jaz404/visarm/notes.md

# Kinematics of 5DOF Arm

## Introduction

Our arm has 6 revolute joints, with no prismatic joints (i.e., the robot can only rotate at places). The wrist rotates as well. It has 3 joints parallel to each other.

### Types of joints

Revolute vs Prismatic Joint

## D-H (Denavit Hartenburg Parameters)

This is a convention used to understand and define the parameters of a robot.

#### Link and Joint Paramters:

- Link Lenght (a<sub>i-1</sub>): It is the mutual perpendictular distance between 2 axis. This is the distance from z<sub>i</sub> to z<sub>i+1</sub>
- Link Twist (α<sub>i-1</sub>): Angle from axis i-1 to i. This is the angle from z<sub>i</sub> to z<sub>i+1</sub> measured about the x-axis.
- Link Offset (d<sub>i</sub>): The offset distance from one link to another. This is the distance from x<sub>i-1</sub> to x<sub>i</sub> along the z-axis
- Joint Angle (θ<sub>i</sub>): Rotation of link with respect to its neighbor (along the common axis). This is the angle from x<sub>i-1</sub> to x<sub>i</sub> measured about the z-axis.

<div align="center">
    Description
</div>

#### Example

<div align="center">
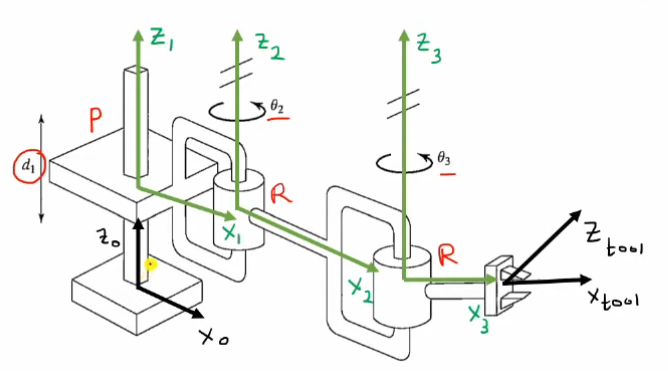
[picture p1: images/1.png]
    

<table>
    <tr>
        <th>Link (i)</th>
        <th>a<sub>i-1</sub></th>
        <th>α<sub>i-1</sub></th>
        <th>d<sub>i</sub></th>
        <th>θ<sub>i</sub></th>
    </tr>
    <tr>
        <td>1</td>
        <td>0</td>
        <td>0</td>
        <td>d<sub>1</sub></td>
        <td>0</td>
    </tr>
    <tr>
        <td>2</td>
        <td>L<sub>1</sub></td>
        <td>0</td>
        <td>0</td>
        <td>θ<sub>2</sub></td>
    </tr>
    <tr>
        <td>3</td>
        <td>L<sub>2</sub></td>
        <td>0</td>
        <td>0</td>
        <td>θ<sub>3</sub></td>
    </tr>
</table>
</div>

## Overview of the arm

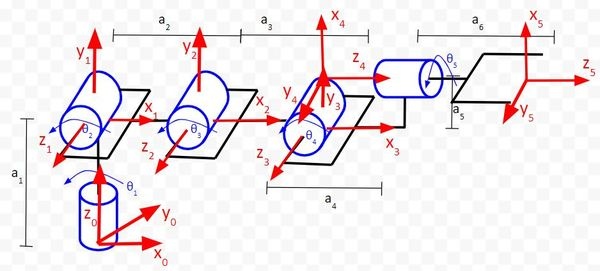
[picture p2: images/diagram.jpeg]


Note:

- θ is the angle from xn-1 to xn around zn-1.
- α is the angle from zn-1 to zn around xn.
- a is the distance between the origin of the n-1 frame and the origin of the n frame along the xn direction.
- d is the distance from xn-1 to xn along the zn-1 direction.

The arm has to following D-H parameters:

| Link (i) | θ<sub>i</sub> (°) | α<sub>i-1 (°) | d<sub>i</sub> (in cm) | a<sub>i-1</sub> (in cm) |
| --- | --- | --- | --- | --- |
| 1 | θ<sub>1</sub> | 90 | a<sub>1</sub> | 0 |
| 2 | θ<sub>2</sub> + pi/2  | 0 | 0 | a<sub>2</sub> |
| 3 | -θ<sub>3</sub> | 0 | 0 | a<sub>3</sub> |
| 4 | -θ<sub>4</sub> + pi/2 | 90 | 0 | a<sub>5</sub> |
| 5 | θ<sub>5</sub> | 0 | a<sub>4</sub> + a<sub>6</sub> | 0 |

(For joints 2, 3, and 4 if you want to change the direction in the global x axis, negate theta.)

Substituting values we get:

| Link (i) | θ<sub>i</sub> (°) | α<sub>i-1 (°) | d<sub>i</sub> (in cm) | a<sub>i-1</sub> (in cm) |
| --- | --- | --- | --- | --- |
| 1 | θ<sub>1</sub> | 90 | 2 | 0 |
| 2 | θ<sub>2</sub> + pi/2  | 0 | 0 | 10.3 |
| 3 | -θ<sub>3</sub> | 0 | 0 | 9.6 |
| 4 | -θ<sub>4</sub> + pi/2 | 90 | 0 | 2.5 |
| 5 | θ<sub>5</sub> | 0 | 9 | 0 |

## Forward kinematics:

This is easy to calculate. Give the angles, the translations and the link lenghts and it will output the position of the end-effector. It works by applying transformation matrices at each joint and hence we get the end-effector position in the final.

## Inverse Kinematics:

### When does inverse kinematics have a closed form solution

The inverse kinematics has a closed form solution in the following two conditions:

- 3 of its joints are parallel to each other
- 3 of its joints has a rotation axis that intersect at a common point.

### Overview

Given the position and orientaion to point to, find the joint angles so that the end-effector moves and orients to the desired point.

### Calculation

Since the robot has 5 revolute joints, we need to find 5 angles to move the robot. This involves transformations from the end-effector to the base of the robot.

#### Velocities

The Jacobian is used to transform the joint velocities into end-effector velocities as follows:

$$
\begin{bmatrix}
ẋ \cr
ẏ \cr
ż \cr
ω_x\cr
ω_y\cr
ω_z\cr
\end{bmatrix}_{6x1} =
J_{6xn}\begin{bmatrix}
q̇_1  \cr
q̇_2 \cr
q̇_3 \cr
... \cr
q̇_n\cr
\end{bmatrix}_{nx1}
$$

Therefore, in our case it would be:

$$
\begin{bmatrix}
ẋ \cr
ẏ \cr
ż \cr
ω_x\cr
ω_y\cr
ω_z\cr
\end{bmatrix}_{6x1} =
J_{6x5}\begin{bmatrix}
θ_1  \cr
θ_2 \cr
θ_3 \cr
θ_4 \cr
θ_5\cr
\end{bmatrix}_{5x1}
$$

#### Jacobian

The jacobian would be a mxn matrix where m represents the dimensions (2D or 3D) and n represents the number of joints. In our case it would be 6x5 matrix as we are in 3D (so 3 for position and 3 for orientation) and 5 joints that determine the arms position / orientation.

The jacobian can be divided into two parts, the first three for linear velocities and the bottom three for angular velocities:

$$
\begin{bmatrix}
J_v  \cr
J_ω \cr
\end{bmatrix}_{6x5}
$$

#### Analytical Method

##### Option 1: Failed
We will try to extract a mathematical formula for the arm so that it is easy to compute. Our robot satifies the Pieper's law as the 2nd, 3rd and 4th joints are parallel and so we can find an analytical solution.

- Assumption 1: The wrist position (Joint 4) depends on the first three joints. (0 to 3)
- Assumption 2: The wrist orientation depends on the last two (that is joint 4 and joint 5). (The homogenous transformation from 5 to 3).

This failed because the arm's 4 joint is not spherical, so it keeps changing. This causes the d5 value in the equation (W = P - d5*Z5) to keep changing based on the orientation of theta 4. Tried to do a brute force approach but didn't give very good results.

##### Option 2: Brute force calulation using the transformation matrices:
A simplified version of this looks as follows:
[-cos(-θ₂ + θ₃ + θ₄))⋅cos(θ₁)⋅cos(θ₅) + sin(θ₁)⋅sin(θ₅), cos(-θ₂ + θ₃ + θ₄))⋅sin(θ₅)⋅cos(θ₁) + sin(θ₁)⋅cos(θ₅), sin(-θ₂ + θ₃ + θ₄)⋅cos(θ₁), (-10.3⋅sin(θ₂) - 9.6⋅sin(θ₂ - θ₃) + 9.0⋅sin(-θ₂ + θ₃ + θ₄) - 2.5⋅cos(-θ₂ + θ₃ + θ₄))⋅cos(θ₁)] = [R11, R12, R13, Px]
[-cos(-θ₂ + θ₃ + θ₄))⋅sin(θ₁)⋅cos(θ₅) - sin(θ₅)⋅cos(θ₁), cos(-θ₂ + θ₃ + θ₄))⋅sin(θ₁)⋅sin(θ₅) - cos(θ₁)⋅cos(θ₅), sin(-θ₂ + θ₃ + θ₄)⋅sin(θ₁), (-10.3⋅sin(θ₂) - 9.6⋅sin(θ₂ - θ₃) + 9.0⋅sin(-θ₂ + θ₃ + θ₄) - 2.5⋅cos(-θ₂ + θ₃ + θ₄))⋅sin(θ₁)] = [R21, R22, R23, Py]
[sin(-θ₂ + θ₃ + θ₄)⋅cos(θ₅), -sin(-θ₂ + θ₃ + θ₄)⋅sin(θ₅), cos(-θ₂ + θ₃ + θ₄), 10.3⋅cos(θ₂) + 9.6⋅cos(θ₂ - θ₃) + 9.0⋅cos(-θ₂ + θ₃ + θ₄) - 2.5⋅sin(-θ₂ + θ₃ + θ₄) + 11.5] = [R31, R32, R33, Pz]
[0, 0, 0, 1] = [0, 0, 0, 1]

Goal: To solve for the joint angles θ₁, θ₂, θ₃, θ₄, and θ₅ given a desired end-effector pose defined by the rotation matrix [R] and position vector [P].
Equations:
1. -cos(-θ₂ + θ₃ + θ₄))⋅cos(θ₁)⋅cos(θ₅) = R11
2. -cos(-θ₂ + θ₃ + θ₄))⋅sin(θ₁)⋅cos(θ₅) = R21
3. sin(-θ₂ + θ₃ + θ₄)⋅cos(θ₅) = R31
4. cos(-θ₂ + θ₃ + θ₄))⋅sin(θ₁)⋅sin(θ₅) = R22
5. -sin(θ₅)⋅cos(θ₁) = R12
6. -sin(-θ₂ + θ₃ + θ₄)⋅sin(θ₅) = R32
7. sin(-θ₂ + θ₃ + θ₄)⋅cos(θ₁) = R13
8. sin(-θ₂ + θ₃ + θ₄)⋅sin(θ₁) = R23
9. cos(-θ₂ + θ₃ + θ₄) = R33
10. (-10.3⋅sin(θ₂) - 9.6⋅sin(θ₂ - θ₃) + 9.0⋅sin(-θ₂ + θ₃ + θ₄) - 2.5⋅cos(-θ₂ + θ₃ + θ₄))⋅cos(θ₁) = Px
11. (-10.3⋅sin(θ₂) - 9.6⋅sin(θ₂ - θ₃) + 9.0⋅sin(-θ₂ + θ₃ + θ₄) - 2.5⋅cos(-θ₂ + θ₃ + θ₄))⋅sin(θ₁) = Py
12. 10.3⋅cos(θ₂) + 9.6⋅cos(θ₂ - θ₃) + 9.0⋅cos(-θ₂ + θ₃ + θ₄) - 2.5⋅sin(-θ₂ + θ₃ + θ₄) + 11.5 = Pz

Solutions:
ϕ=-θ2+θ3+θ4
Then the equations become:
1. -cos(ϕ)⋅cos(θ₁)⋅cos(θ₅) = R11
2. -cos(ϕ)⋅sin(θ₁)⋅cos(θ₅) = R21
3. sin(ϕ)⋅cos(θ₅) = R31
4. cos(ϕ)⋅sin(θ₁)⋅sin(θ₅) = R22
5. -sin(θ₅)⋅cos(θ₁) = R12
6. -sin(ϕ)⋅sin(θ₅) = R32
7. sin(ϕ)⋅cos(θ₁) = R13
8. sin(ϕ)⋅sin(θ₁) = R23
9. cos(ϕ) = R33
10. A⋅cos(θ₁) = Px
11. A⋅sin(θ₁) = Py
12. B = Pz

Where:
A = -10.3⋅sin(θ₂) - 9.6⋅sin(θ₂ - θ₃) + 9.0⋅sin(ϕ) - 2.5⋅cos(ϕ)
B = 10.3⋅cos(θ₂) + 9.6⋅cos(θ₂ - θ₃) + 9.0⋅cos(ϕ) - 2.5⋅sin(ϕ) + 11.5

θ₁ = atan2(Py, Px)
θ₅ = atan2(-R12/cos(θ₁), -R11/(cos(ϕ)⋅cos(θ₁)))
ϕ = atan2(R31, R33) or ϕ = acos(R33)
θ4 = ϕ + θ2 - θ3
Solve for θ2 and θ3 using equations 10, 11, and 12.

This starts with an approximation, so it is not the best as there are some errors induced.

## Documentation

https://learn.adafruit.com/16-channel-pwm-servo-driver?view=all  
Servo driver library:  
https://github.com/NachtRaveVL/PCA9685-Arduino  
>Note: The servo.read() function does not provide feedback on the actual, current physical position of the servo motor shaft. Standard hobby servos are "open-loop" systems from the Arduino's perspective; the Arduino only sends a command signal and does not receive the actual position back from the servo's internal potentiometer.

## Joint Bounds

| Motor | Joint Name | Motion 1 (°) | Motion 2 (°) |
| ----- | --- | --- | --- |
| 1 | Base (ch 0) | +90 | -80 |
| 2 | Shoulder (ch 1) | +30 | -80 |
| 3 | Elbow (ch 2) | +90 | -90 |
| 4 | Wrist Roll (ch 3) | +90 | -90 |
| 5 | Wrist Yaw (ch 4)  | +90 | -90 |
| 6 | Gripper (ch 5) | +65 (open) | +90 (close)  |

## References

- https://www.youtube.com/watch?v=wDus2EKLg3s
- https://automaticaddison.com/the-ultimate-guide-to-jacobian-matrices-for-robotics/
- https://automaticaddison.com/homogeneous-transformation-matrices-using-denavit-hartenberg/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
- https://automaticaddison.com/the-ultimate-guide-to-inverse-kinematics-for-6dof-robot-arms/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

## Things to look into

- https://moveit.github.io/moveit_tutorials/doc/hand_eye_calibration/hand_eye_calibration_tutorial.html
- https://openrave.org/docs/0.8.0/openravepy/ikfast/

Home Position: -2, 0, 53, 90, 0, 0
