jaz404/visarm/assets/VISARM.pdf

CMPUT 312 FINAL PROJECT | 1

# Visarm: Vision based Pick-and-Place Robotic Arm

Jaspreet Singh Chhabra and Krupal Shah

Abstract—This project was aimed to create a 4DOF vision based pick-and-place system to color sort objects, enabling autonomous object localization, grasping, and placement. The process starts with correcting lens distortion to obtain a geometrically accurate view of the scene. A checkerboard workspace is then detected and used as a reference plane for mapping imagespace object locations into robot coordinates. Once objects within the workspace are detected, their positions are transformed into the robot frame solved using inverse kinematics. Inverse kinematics generates multiple solutions, which are evaluated through forward kinematics to identify a reachable solution. The robot executes the selected trajectory to grasp the object, followed by a verification step that confirms whether the pickup was successful. Successful grasps are subsequently placed into predefined bin locations. The system combines calibrated geometric vision with closed-loop grasp verification to ensure robust and consistent manipulation in a structured environment.

Index Terms—Robotic arms, Object Detection, Camera Calibration

I. INTRODUCTION
P
ICK-AND-PLACE systems using computer vision on robotic manipulators represent a core capability in modern automation, enabling robots to recognize, localize, and manipulate objects with minimal human intervention. In our final project, we investigate a vision-guided pick-and-place task to color sort objects using a 4-degree-of-freedom (4DOF) robotic arm. Such systems are widely used in real-world applications such as automated sorting in manufacturing lines, warehouse item classification, recycling facilities where materials are separated by type or color, and food processing environments that depend on visual inspection and sorting.

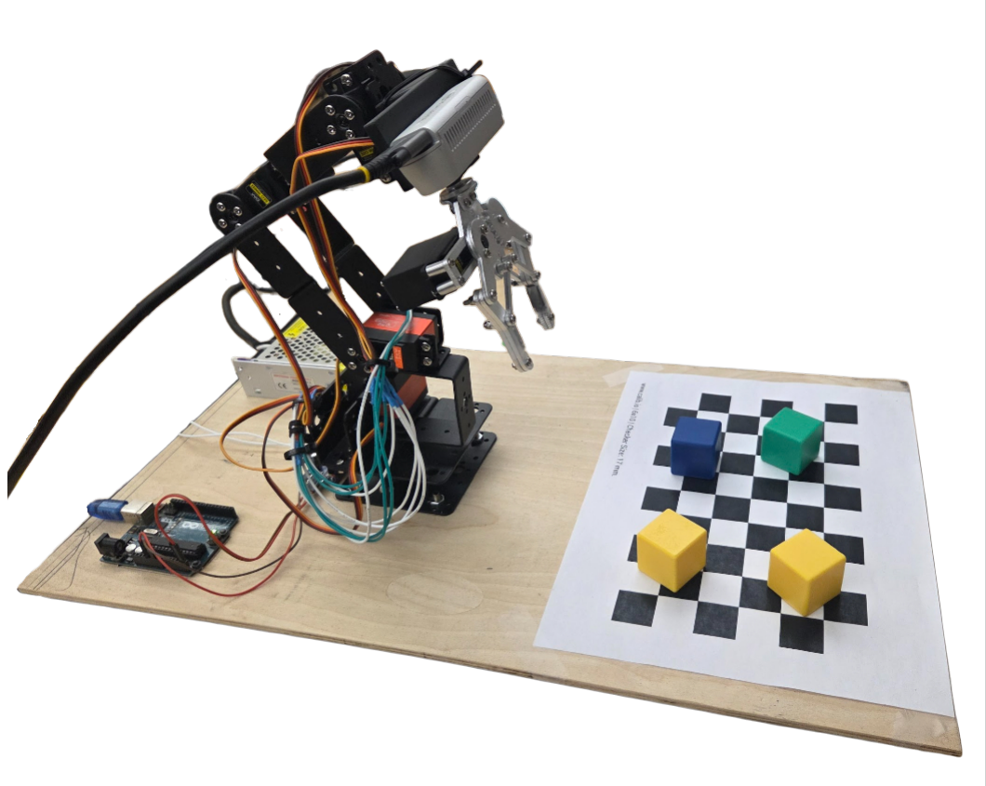
[picture p3: figure]

Fig. 1: Visarm Robotic Arm for Pick and Place

The use of a 4DOF robotic arm is particularly interesting because it offers a balance between mechanical simplicity and functional capability. With four independent joints, the robot can achieve a wide range of poses suitable for planar manipulation tasks while still presenting manageable kinematic complexity for analysis and control. The motivation for this project is to extend the knowledge gained from the CMPUT 312 course material and lab exercises to a more complex and sophisticated real-world robotic platform. Implementing vision-based control on a physical 4DOF robot provides practical experience with sensor integration, calibration challenges, and real-time motion execution, thereby deepening our understanding of robotic concepts and preparing for more advanced research or industrial applications.

II. RELATED WORKS

Previous research has demonstrated that even relatively simple manipulators, such as 3-DOF or 4-DOF robotic arms, can be effectively combined with computer vision systems to perform sorting and pick-and-place tasks. For instance, a 4-DOF robotic arm employing color-based image processing was used to sort colored balls in [1], while Gashi et al. [2] utilized a 3-DOF arm for object sorting. Despite the rise of deep learning approaches, many object detection and grasping tasks continue to rely on classical image processing techniques due to their lower computational cost, faster execution, greater predictability, and reduced data requirements [3]. These methods also offer easier calibration and deterministic behavior, particularly when the objects are simple, the background is controlled, and task speed is not critical.

Common techniques include color-based segmentation in HSV or other color spaces combined with contour detection and masking [4], edge detection methods such as the Hough transform, and hybrid pipelines that integrate 2D camera data with depth information to improve object localization [3]. These techniques have been studied extensively and applied in the CMPUT 312 course which have been extended in this project.

III. METHODOLOGY

A. Hardware

The core of the system is a low-cost robotic arm purchased from Amazon for approximately $80. Although advertised as a 6-DOF platform, the arm provides 5 functional degrees of freedom and is constructed primarily from sheet metal. The stock MG966R/MG996R servos offer approximately 13 kg·cm of torque and are driven by standard PWM signals without any onboard feedback mechanisms.

An Intel RealSense D435i camera was mounted on Joint 4 using a custom 3D-printed bracket to provide full visibility of the workspace. Due to the added weight of the camera, the base and shoulder servos were unable to provide sufficient torque for stable manipulation. These servos were replaced with higher torque Miuzei units rated at 22.8 kg·cm.

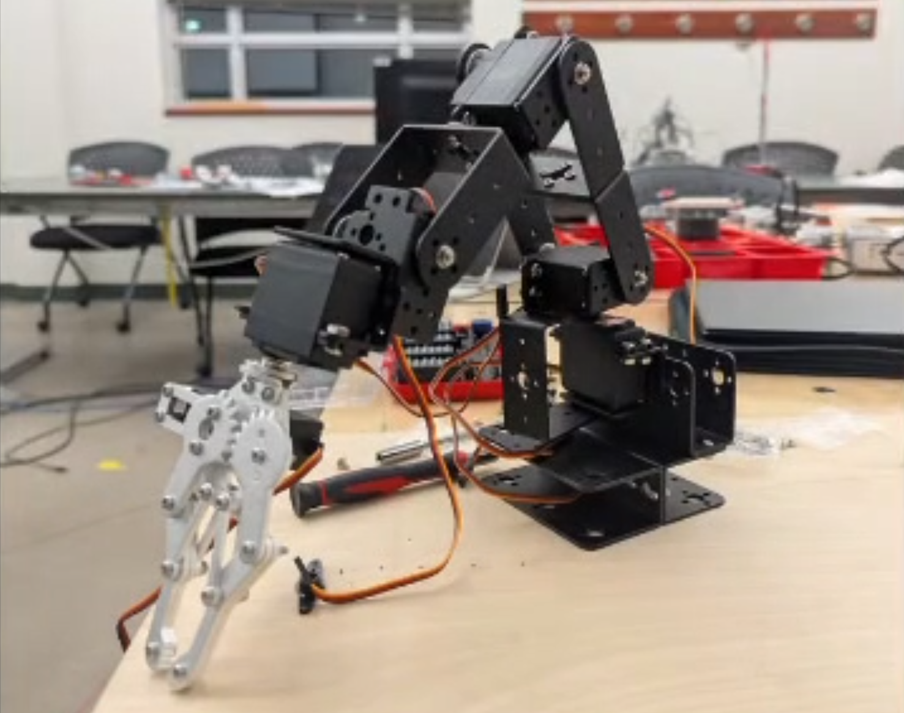
[picture p4: figure]

Fig. 2: Assembled Arm

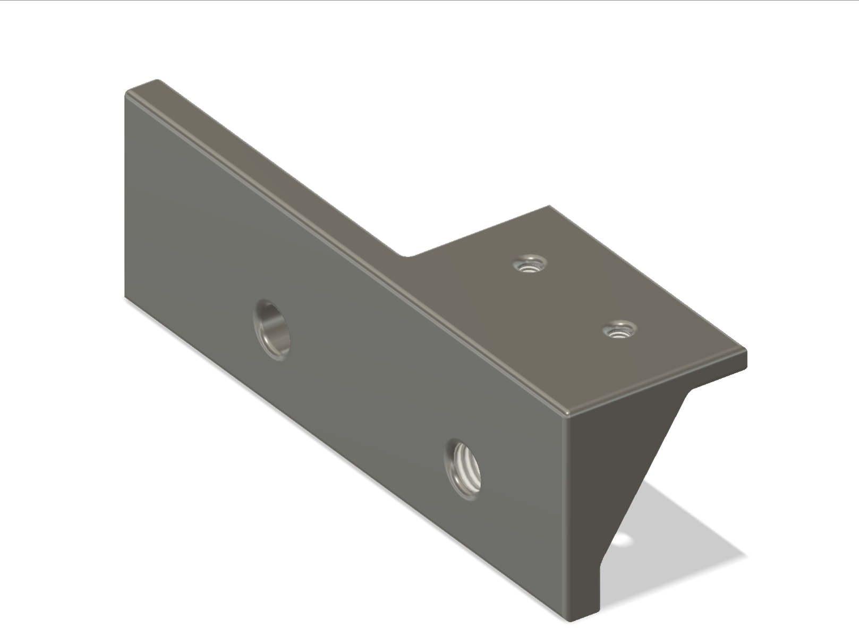
[picture p5: figure]

Fig. 3: 3D Printed Camera Mount for Intel RealSense

For controlling the motors, an Arduino UNO together with a PCA9685 16-channel PWM servo driver was used. The UNO receives serial commands from the host computer and generates the corresponding PWM signals for the servos. Because six servos draw a considerable amount of current under load, a 5 V switching-mode power supply capable of providing 10 A was sourced. All components were mounted on a 1/4” plywood board. The overall wiring layout, including the servo driver and power distribution, is illustrated in Figure 4. The workspace was defined using a 6×10 checkerboard with 23 mm tiles, which was also affixed to the board.

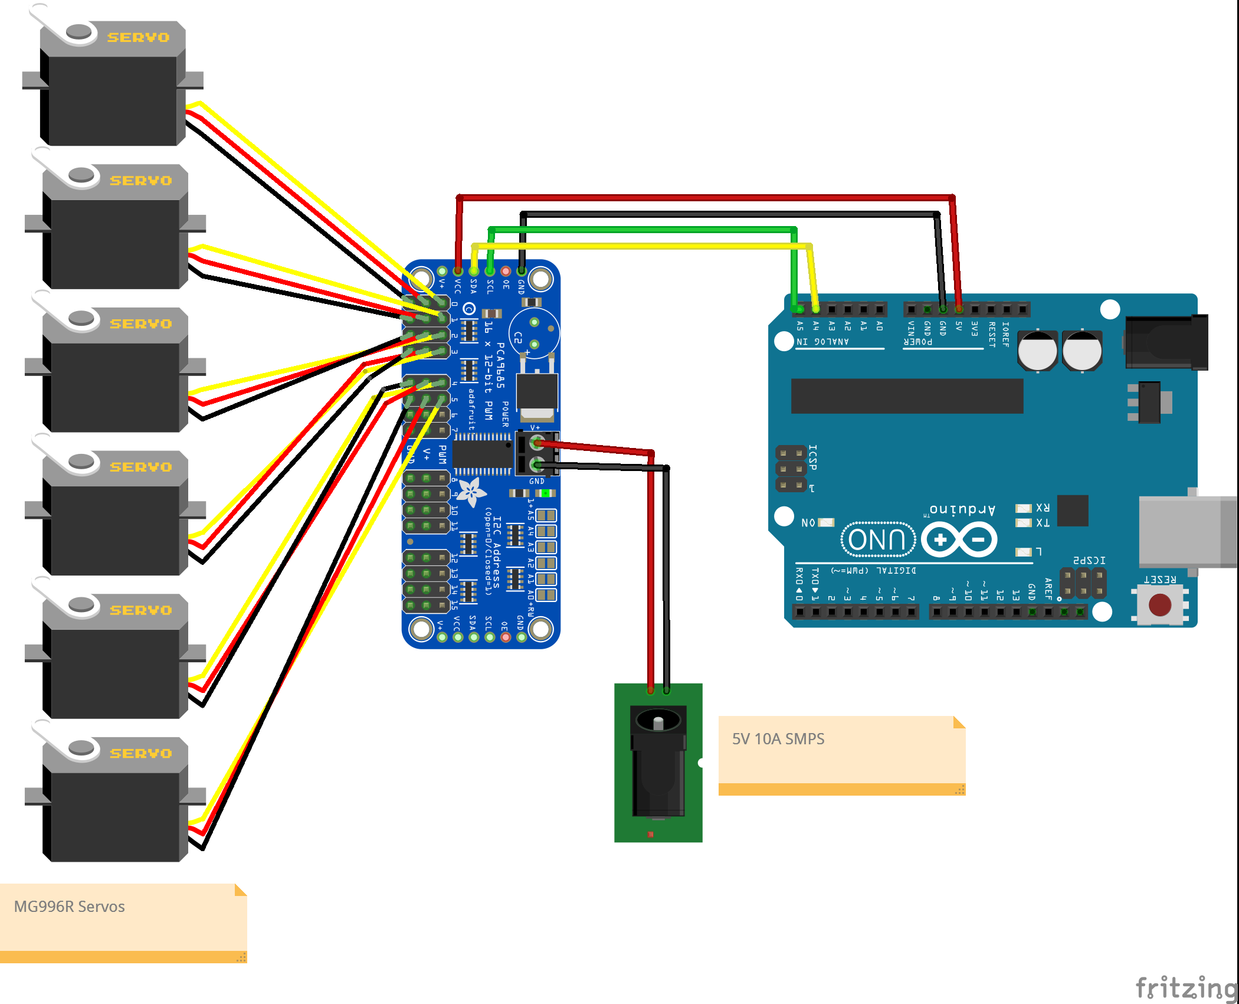
[picture p6: figure]

Fig. 4: Circuit Diagram for Visarm.

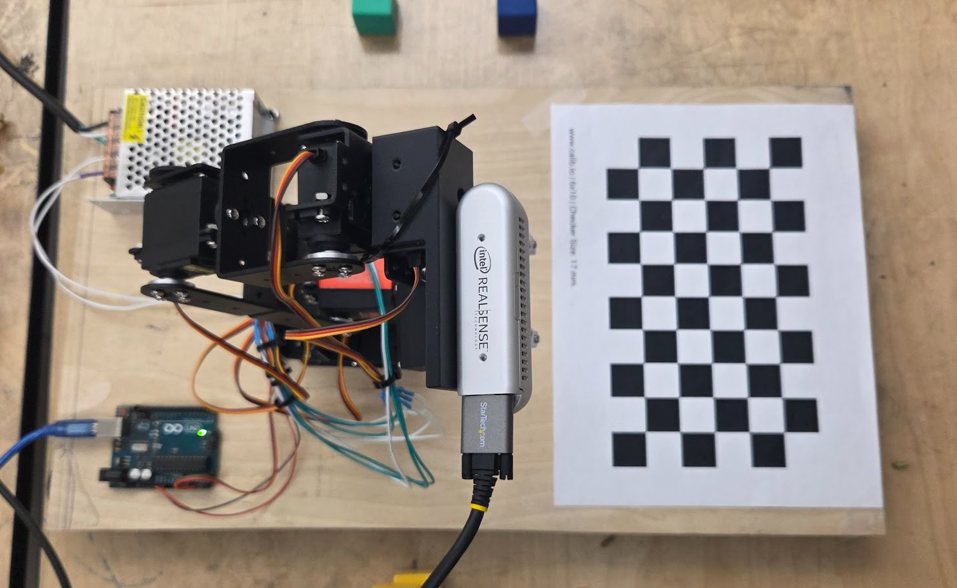
[picture p7: figure]

Fig. 5: Visarm final setup

The overall system operates using a client–server architecture. The host computer executes all high-level
tasks, | including | camera-based | perception, | workspace
calibration, coordinate transformation, and forward and inverse kinematics. The Arduino functions as the client, handling all low-level actuation tasks by converting the received joint angles into PWM signals for the servo controller.

Communication between the host and the Arduino is hosted over a USB serial connection using a simple ASCII-based command protocol, illustrated in Figure 6. This lightweight message structure enables transmission of joint commands and retrieval of the current arm state.

Fig. 6: Arduino-Client Serial Message Structure.

B. Forward Kinematics
In order to control our robotic arm and move it around the workspace, we needed to solve the forward kinematics of our robot so we could determine the end-effector position given the current joint angles. We used the Denavit-Hartenberg (DH) convention to model the forward kinematics of our arm [5]. We started by assigning coordinate frames to each joint position (F1, F2, F3, F4, F5, F6), including the base frame FB and the end-effector frame FE. From these frames, we found the DH parameters as defined in Table I.

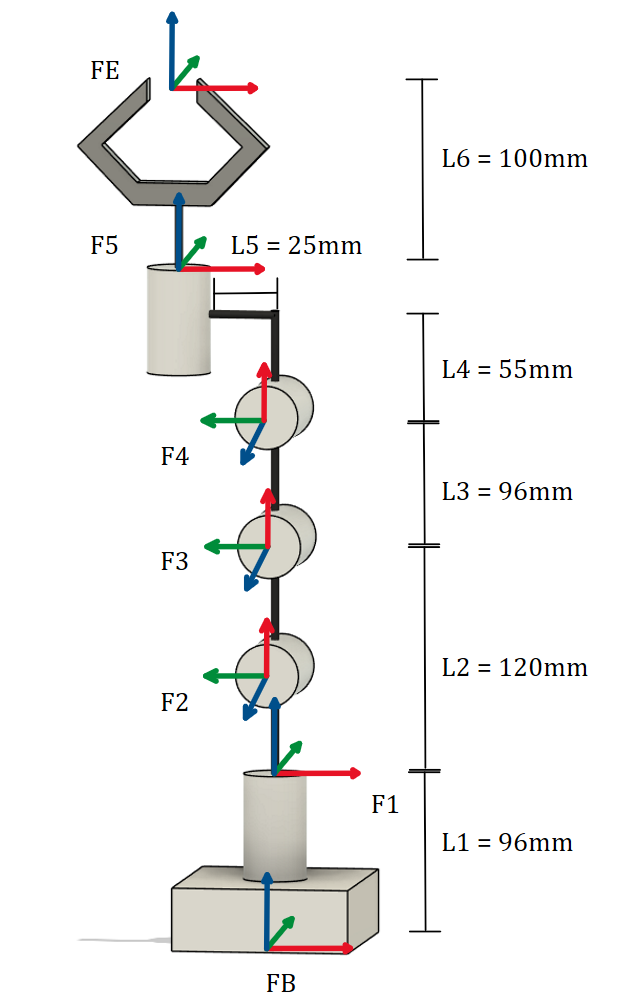
[picture p8: figure]

Fig. 7: Visarm Coordinate Frames

Link (i) | θi (rad) | αi−1 (rad) | di (mm) | ai−1 (mm)
1 2 3 4 5 | θ1 θ2 −θ3 −θ4 + π/2 θ5 | π/2 0 0 π/2 0 | 96 0 0 0 55 + 100 | 0 120 96 25 0

TABLE I: DH Parameters of the 5-DOF Arm

Multiplying all of the transformation matrices together will produce a single transformation matrix between the base frame of the robot to the end-effector. This final transformation matrix is the forward kinematics solution for our robot. Equation 1 shows the change of transformations and Equation 2 shows the position of the end-effector from the base frame of the robot.

BTE =

BT1

1T2

2T3

3T4

4T5

5TE. | (1)

pEE =

−12 s2c1 − 9.6 s23c1 + 15.5 s−2+3+4c1 − 2.5 c−2+3+4c1 + 9.6

−12 s1s2 − 9.6 s1s23 + 15.5 s1s−2+3+4 − 2.5 s1c−2+3+4

12 c2 + 9.6 c23 + 15.5 c−2+3+4 + 9.6

(2)
where

si = sin θi

, | ci = cos θi ,
sij = sin(θi − θj ), | cij = cos(θi − θj ),
s−2+3+4 = sin(−θ2 + θ3 + θ4), | c−2+3+4 = cos(−θ2 + θ3 + θ4).
C. Inverse Kinematics

Inverse kinematics (IK) refers to the computational process of determining the joint parameters required to achieve a desired position and orientation of a robot’s end-effector. Unlike forward kinematics, which is easy to calculate from transformation poses, inverse kinematics is much more complicated and has no straight-forward general solution because there might be multiple solutions or even no solutions to a specific point.

In order to map world coordinates to joint angles, we make use of trigonometry. We break down our robot into multiple subproblems and we try to find solutions to the subproblems. We are given the position for the end-effector to reach (x, y, z). Even though the robot is 5DOF, we only consider a 4DOF robot for simplicity, i.e., joint 5 is fixed.

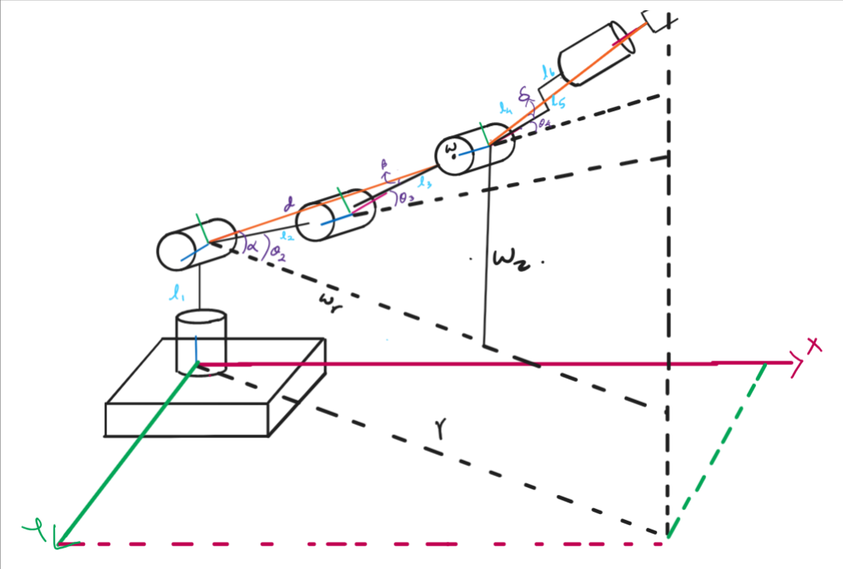
[picture p9: figure]

Fig. 8: Inverse kinematics Diagram

From Figure 8:

θ1 = arctan y
x
(3)

We shift the entire plane by l1, in order to solve for the subproblem θ2, θ3, θ4. We find that three 3 angles from a planar arm and hence can be solved using the planar arm equations.

Lee =

q
L

2
5 + (L

2
4 + L

2/6)

r = x cos θ1 + y sin θ1
wr = r − Lee cos ϕ
wz = z − Lee sin ϕ

d =

p
w²

r + w²
z

θ3 = arccos
−(d

2 − L
2
2 − L

2/3)
2L2L3
(4)

Using the Law of Cosines:

α = arctan
wz
wr

β = arccos
L

2
2 + d

2 − L

2
3
2L2d

θ2 =

(
(α + β) −

π
2

,
(α − β) −

π
2

(5)

Finally,

δ = arctan
L5
L4 + L6

θ4 = θ2 + θ3 + δ − ϕ +

π
2

(6)

There are many combinations possible and not all candidates are valid solutions for our robot configuration. To determine which combinations of joint angles are actually valid, we plug the candiates back into the forward kinematics to see if the joint angles bring the end-effector to the desired position.

D. Camera Calibration and Mapping
Camera calibration is performed to accurately recover a camera’s intrinsic parameters, extrinsic parameters, and lens distortion. Using MATLAB’s Camera Calibrator App, this is done by capturing roughly 10–15 checkerboard images from varied viewpoints, making sure the pattern covers diverse orientations and positions across the camera’s field of view.

Checkerboard calibration works by detecting the corners of the black-white grid, whose geometry is known a priori. Since the spacing between corners is fixed, the app solves for the camera intrinsics (focal length, principal point, and distortion coefficients) and extrinsics (rotation and translation of the camera relative to the checkerboard) by minimizing the reprojection error-the difference between observed corner locations and the projection of their corresponding 3D points.

Figure 9 shows the estimated camera poses in the checkerboard (world) coordinate frame, confirming good spatial coverage during image collection. The reprojection error plot in Figure 10 indicates a mean reprojection error of approximately 0.20 pixels, demonstrating accurate calibration. As the Intel RealSense D435i does not use a fisheye lens, distortion is relatively modest; however, a small amount of radial distortion was detected and corrected using the estimated distortion coefficients.

The calibrated intrinsic matrix and radial distortion coefficients obtained from the MATLAB Camera Calibrator are:

K =

898.3306 | 0 | 633.6178
0 | 898.7783 379.6450
0 | 0 | 1

, | dradial =

"
0.1402

−0.2897#

(7)

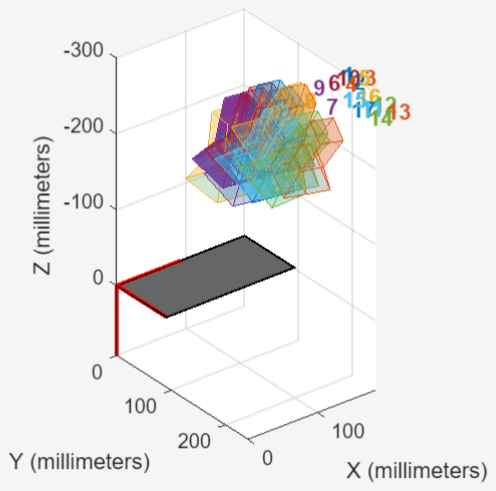
[picture p10: figure]

Fig. 9: Estimated Camera Positions from Camera Calibrator App

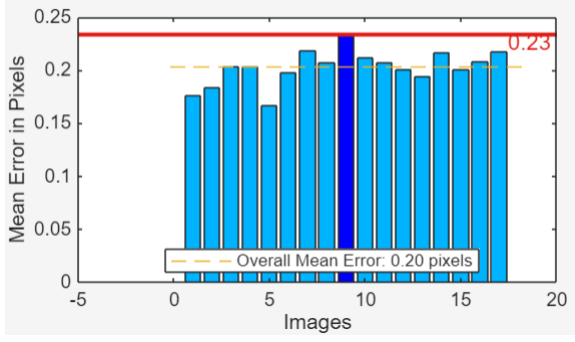
[picture p11: figure]

Fig. 10: Reprojection Errors in Calibration

Using these results, we can map image pixel coordinates to world coordinates by constructing a transformation Tchecker→camera. After undistorting the pixel locations, the intrinsic matrix is inverted to obtain normalized camera-frame rays. These rays are then intersected with the checkerboard plane, whose pose relative to the camera is determined from the extrinsic calibration.

Since the workspace is planar and the objects handled by the robot have predetermined heights, we apply a planar assumption by fixing Z = 0 in the world frame. This reduces the 3D mapping problem to a 2D homography transformation between the image plane and the checkerboard plane, allowing each detected object centroid in pixels to be mapped directly into metric coordinates in the robot’s workspace.

The transformation Tchecker→robot can be visually determined from the physical setup, as shown in Figure 11. This homogeneous transform can be decomposed into a rotation matrix R and a translation vector T:

Tchecker→robot =

0 | −1 | 0 | 305
−1 | 0 | 0 | 122
0 | 0 | −1 | 0
0 | 0 | 0 | 1

(8)

where the rotation and translation components are

R =

0 | −1 | 0
−1 | 0 | 0
0 | 0 | −1

- , T =

305

122

0

- . | (9)

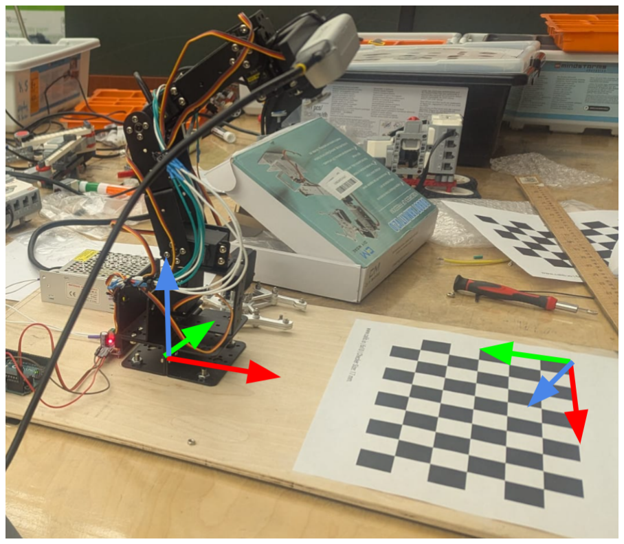
[picture p12: figure]

Fig. 11: Coordinate Frames of Robot and Checkerboard

Using the two transformations defined above, a pixel in the image frame can be mapped directly into the robot frame. In homogeneous coordinates, the mapping is expressed as

probot = Tchecker→robot Timage→checker pimage. | (10)

Equivalently, starting from a point in the robot frame, its projection into the image plane is given by

pimage = Tchecker→image Trobot→checker probot. | (11)
E. Object Detection

After computing the camera calibration parameters and determining the pixel to robot transformation, the next stage involves detecting colored objects placed within the workspace defined using the checkerboard. The robot arm is first moved to a fixed survey position as in Figure 12. This configuration provides a consistent and unobstructed workspace view and is defined using the following joint angles:

POSsurvey = [−6, 29, 77, 90, 0, −10].

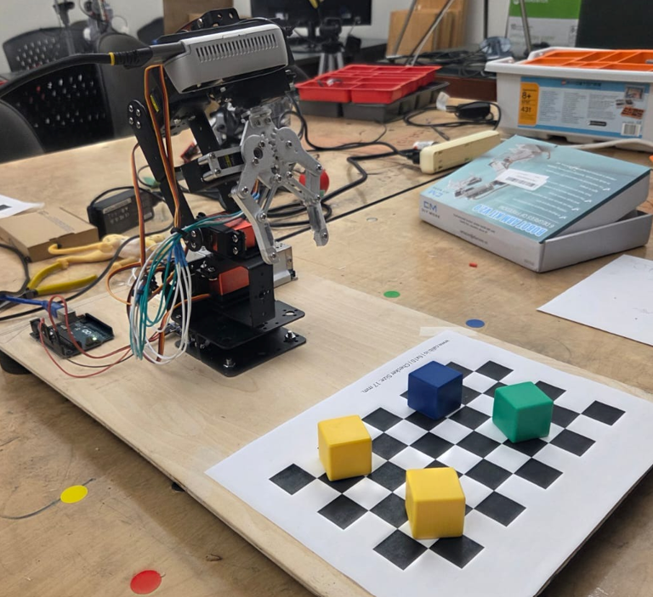
[picture p13: figure]

Fig. 12: Visarm Survey Position.

1) Workspace Initialization: The workspace defined using the checkerboard is detected using the four outer vertices. These bounds are then stored in the camera parameter file and subsequently used to mask all frames coming from the camera. A comparison of unmasked and masked workspace can be seen in Figure 13.
2) Undistortion and Contrast Enhancement: Each frame from the camera is first undistorted using the intrinsic matrix K and distortion vector d:
Iundist = undistort(Iraw, K, d). | (12)

To improve robustness to lighting variation, contrast-limited adaptive histogram equalization (CLAHE) is applied to the Vchannel of the HSV representation:

Ieq = CLAHE(HSVV (Iundist)). | (13)
3) Workspace Masking: A binary mask corresponding to the checkerboard outline is applied to isolate the sorting area:
Imasked = Ieq ⊙ Maskboard. | (14)

Only objects fully contained within this workspace are considered for detection (see Figure 13).

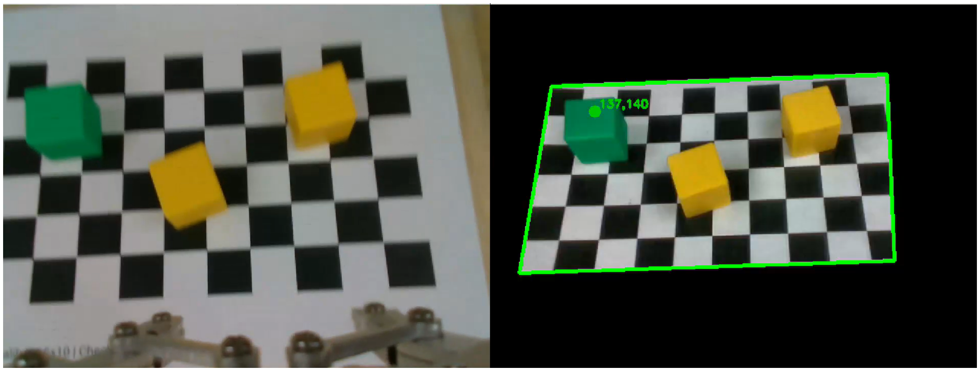
[picture p14: figure]

Fig. 13: Unmasked and Masked Workspace.

4) Color Based Segmentation and Contour Extraction: Objects are detected using color thresholding in HSV space:

M = inRange(HSV(Imasked), lower, upper). (15)

This is then followed by median filtering and morphological opening to remove noise. External contours are then extracted, and each contour is filtered by area and shape to remove hand intrusions and noise. The centroid of each valid contour is computed and is considered as a candidate object location.
5) Vertical Offset Correction: Slight adjustments are made to the position of the object as the object detection pipeline finds the center of the blob rather than the top face of the cube. A vertical offset proportional to the normalized y-position is subtracted to correct this error. A max err of 1cm was found which is corrected here:

c

corrected
y | = cy −
max err ·

cy − ytop
H
. (16)

where H is the vertical span of the workspace in pixels. After performing all the above steps, this is how a detection looks like in the workspace:

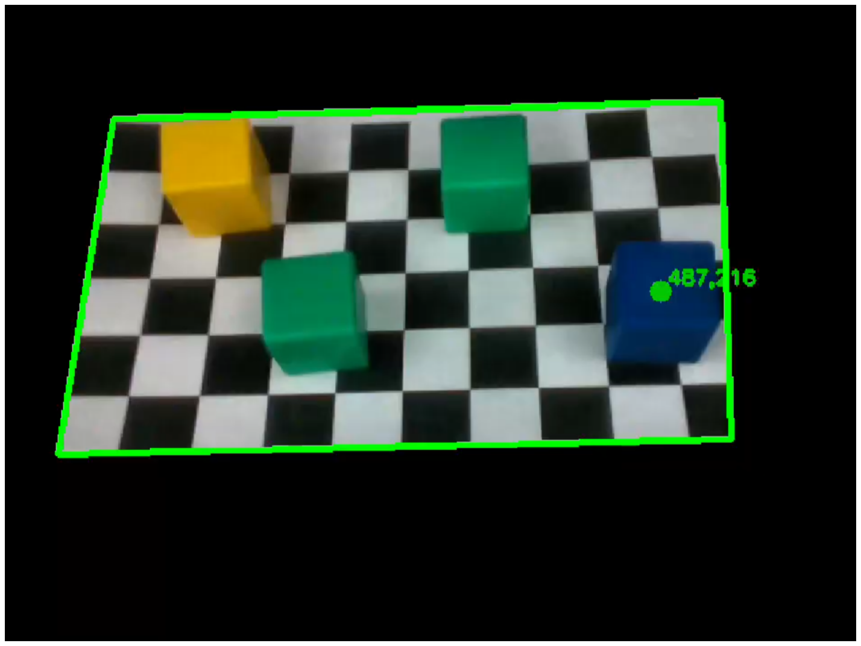
[picture p15: figure]

Fig. 14: Object Detection after Correction.

After grasping has been performed, the robot returns to the survey position, and a verification step is executed to determine whether an object is present in the gripper. A fixed region of interest (ROI), corresponding to the expected projection of a grasped cube, is first extracted from the incoming frame. To this mask, an HSV threshold based on saturation is applied to isolate brightly colored regions, and the largest contour in the workspace is selected. A median blur is applied to suppress noise before extracting external contours. A pickup is only considered successful if the following conditions are satisfied:
(i) the contour area exceeds a predefined threshold, (ii) the bounding box exhibits a reasonable aspect ratio, and (iii) the detected region is horizontally centered and located in the lower portion of the ROI.
F. Pick-and-Place
At this point, we now had all the necessary components to complete the pick-and-place task. First, the arm is moved to a survey position from which the entire checkerboard is visible. The bounding box of the checkerboard is calculated from this position. Then, the objects are placed on the checkerboard to sort them. The image processing pipeline runs on the images to pick out the colored cubes (Section III-E). The camera parameters are used to project the pixel coordinates of the cubes into checkerboard coordinates (Section III-D). Then the checkerboard coordinates are converted into robot coordinates. The position is corrected using the error mechanism defined in Section III-E.

Inverse Kinematics is used to send the robot up to pick up the object (Section III-C). The object height is 3cm, with an added 2cm offset for robot error, giving a hardcoded height of 5cm. Then the arm comes back to the survey position to check if the arm has successfully picked up the object. It does this using the camera mounted on the arm. If the arm has not detected any, then it will try picking the object again; otherwise it will successfully move to place the object to the appropriate bin position based on its color. With all these steps combined, we finally had a fully-fledged design for picking up and sorting the colored objects. Also, an angular offset is applied to θ1 based on the target position to compensate for the motor’s physical configuration: −6

- when the y-position
is below 6.7 cm, and 0
- otherwise.

IV. RESULTS

The performance of the 4-DOF robotic arm for pick-andplace and color-sorting tasks was evaluated through physical measurements and multiple experimental trials. The arm exhibits a positional error of approximately 1 cm in both the x and y axes (see Figure 15) when executing the inverse kinematics. As a result, the arm successfully picks up objects about 70% of the time. Failures generally occur when the object is oriented unfavorably, primarily because joint 5 is fixed at 0

◦
, which limits the wrist’s ability to adjust the end-effector orientation.

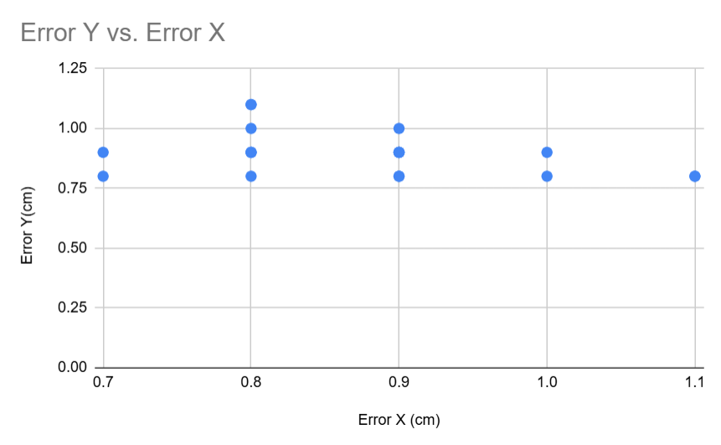
[picture p16: figure]

Fig. 15: Positional Errors in X vs Y

Color recognition was accurate in approximately 90% of trials. Most errors stem from the use of HSV color space, which is sensitive to lighting variations and occasionally leads to misclassification of object colors.

In addition to these computational errors, the arm’s joints were not mechanically aligned when assembled, which introduced consistent angular biases in the kinematic chain. To compensate for these assembly related errors, fixed joint offsets were applied during calibration, that is, θ1 required a 6

◦
adjustment. This alignment offset is distinct from the deflection-related compensations described below and are incorporated directly into the joint angles prior to any kinematic computation.

Beyond these alignment errors, the additional weight of the camera, its mount, and the grasped object caused the arm to exhibit noticeable structural deflection. This resulted in systematic positioning errors during pick-and-place operations. To compensate for these effects, two corrective offsets were introduced (see Figure 16).
1) Origin Offset: A correction was applied to θ2 to shift the robot’s effective origin slightly behind the true physical origin.
2) Position-Dependent Offset: A secondary correction was applied based on the detected object position. If the detected object’s X-coordinate exceeded a defined threshold, an additional bias was introduced in θ1.

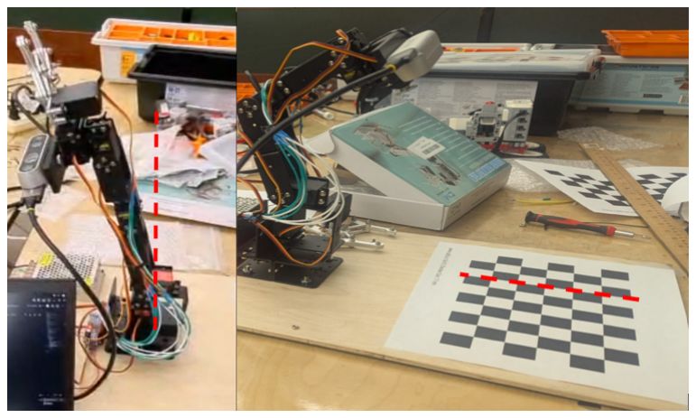
[picture p17: figure]

Fig. 16: Origin [Left] and Position-Dependent [Right] Offset

V. CONCLUSION AND FUTURE WORK
This project successfully implemented a 4-DOF vision-based pick-and-place system capable of autonomous sorting objects of different colors through localization, grasping, and placement. The system combines classical image processing, HSV-based color detection, and analytical inverse kinematics to perform these tasks. Experimental evaluation through physical measurements and multiple trials showed that the arm achieves approximately 1 cm positional accuracy in both x and y directions, with a successful grasp rate of around 70% and color recognition accuracy of about 90%.

In the future, we plan to enhance the robustness and accuracy of the system by replacing the checkerboard reference with ARUCO markers, which are more tolerant to detection errors. Unlike the checkerboard, where the reference may shift and errors accumulate over multiple iterations, especially since the bounding box cannot always be reliably detected (see Figure 17), ARUCO markers allow recalibration at each iteration, preventing error accumulation and ensuring more accurate results.

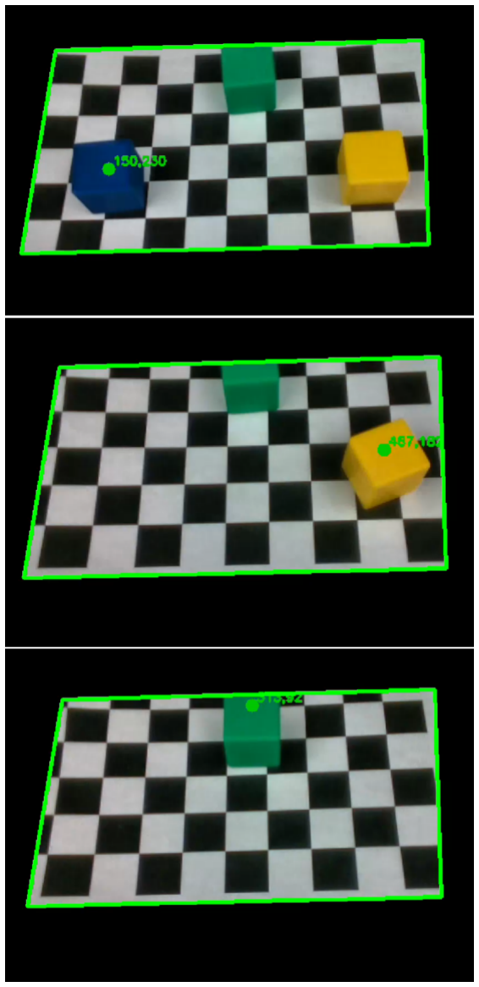
[picture p18: figure]

Fig. 17: Cumulative Error due to Checkerboard Drift

In addition to improving workspace definition, we also aim to introduce visual servoing to address end-effector misalignment observed during grasping. Due to the arm’s positional inaccuracies and the limited span and surface area of the gripper, the end-effector often approached the cube with small lateral or angular deviations, resulting in unsuccessful grasps. A visual servoing approach would enable feedback to iteratively align the gripper with the object before closing. Specifically, the alignment error can be defined using a pointto-line metric, where the two endpoints of the gripper serve as point features, and the two opposite vertical edges of the cube are modeled as reference lines (see Figure. 18). By minimizing this error, the gripper can be dynamically adjusted to the correct orientation and position, reducing the reliance on corrective offsets.

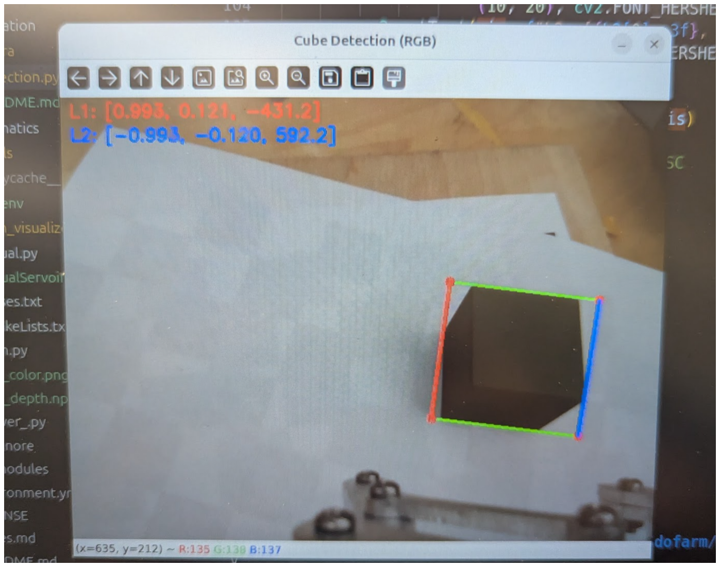
[picture p19: figure]

Fig. 18: Point-to-line Error

Lastly, the gripper servo experienced significant overheating and ultimately required replacement. The main cause behind this was that the servos used in the system provide no force feedback-or any feedback mechanism in general while a high gripping force was required to secure the cube. The gripper was commanded to close to a fixed angle that ensured a strong grasp, but this also caused the servo to stall under load, accelerating wear. A way to fix it would be to check for cube detection during the pickup instead of waiting till the arm returns to the survey position. This could be achieved either through a visual check as we are doing above or by installing limit switches to detect contact. If the object is confirmed to be grasped, the command being sent to close the gripper can be relaxed to avoid stalling the servo.

The code and additional documentation are available on GitHub to encourage collaboration and further development: https://github.com/jaz404/visarm

ACKNOWLEDGMENT
We would like to thank our professor Martin Jagersand and our TAs Riley Zilka and Justin Valentine for their continuous support and guidance to help complete this project successfully. We also gratefully recognize the project by Nakamura et al. [1] as having provided valuable inspiration in shaping aspects of this work

REFERENCES
[1] K. Nakamura, O. Sullivan, and E. Carmody, Kainakamura/rbe3001: A 4-dof serial robotic arm designed for pick-and-place. [Online]. Available: https://github.com/KaiNakamura/RBE3001.
[2] A. Gashi, D. Krasniqi, E. Shala, X. Bajrami, and R. Likaj, “Automated robotic arm for object detection and classification,” in 2025 14th Mediterranean Conference on Embedded Computing (MECO), 2025, pp. 1–5. DOI: 10.1109/MECO66322.2025.11049290.
[3] G. Du, K. Wang, S. Lian, and K. Zhao, Vision-based robotic grasping from object localization, object pose estimation to grasp estimation for parallel grippers: A review, Oct. 2020. [Online]. Available: https://arxiv.org/abs/1905.06658.
[4] H. Q. T. Ngo, “Using hsv-based approach for detecting and grasping an object by the industrial mechatronic system,” Results in Engineering, vol. 23, p. 102 298, 2024, ISSN: 2590-1230. DOI: https : / / doi . org / 10 . 1016 / j . rineng . 2024 . 102298. [Online]. Available: https : / / www . sciencedirect . com / science / article / pii / S259012302400553X.
[5] J. Denavit and R. S. Hartenberg, “A kinematic notation for lower-pair mechanisms based on matrices,” Journal of Applied Mechanics, vol. 22, no. 2, pp. 215–221, Jun. 1955. DOI: 10.1115/1.4011045.
