jaz404/visarm/output/image_1.png

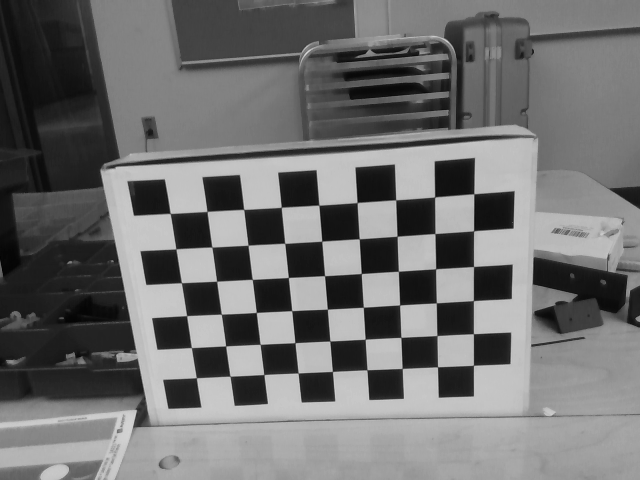
output/image_1.png
