jaz404/visarm/output/image_2.png

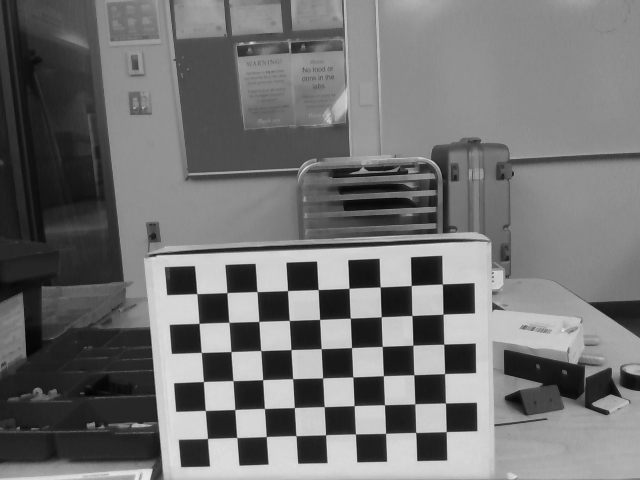
output/image_2.png
