jaz404/visarm/output/image_3.png

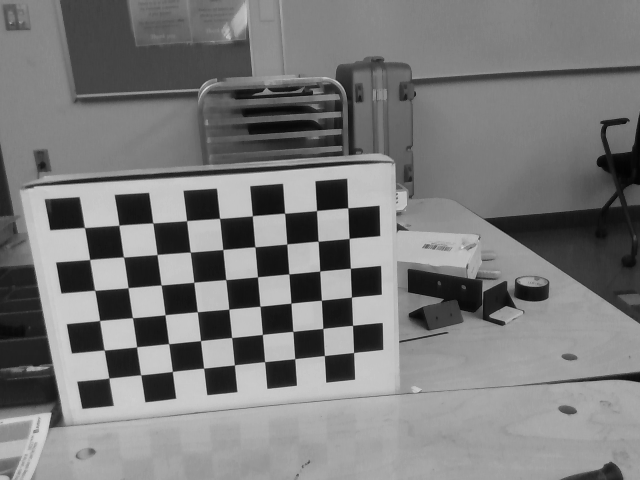
output/image_3.png
