jaz404/visarm/output/image_4.png

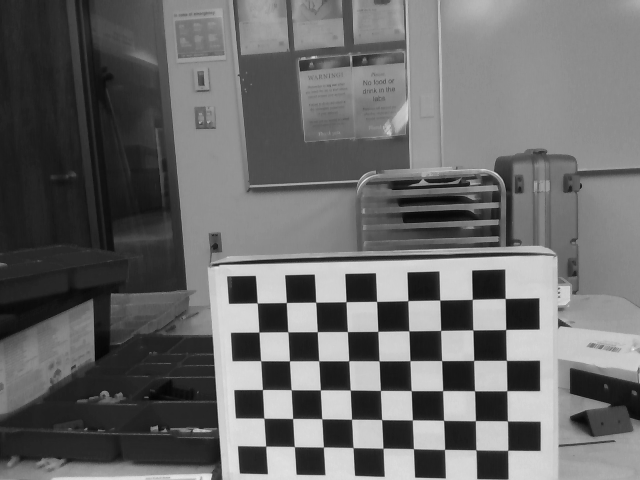
output/image_4.png
