jaz404/visarm/output/image_5.png

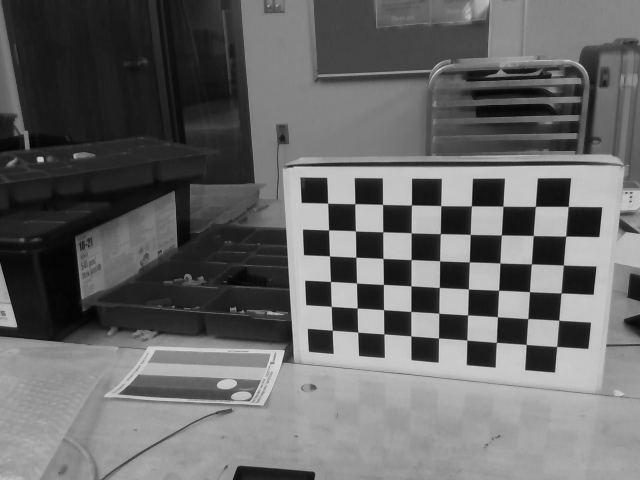
output/image_5.png
