jaz404/visarm/output/image_6.png

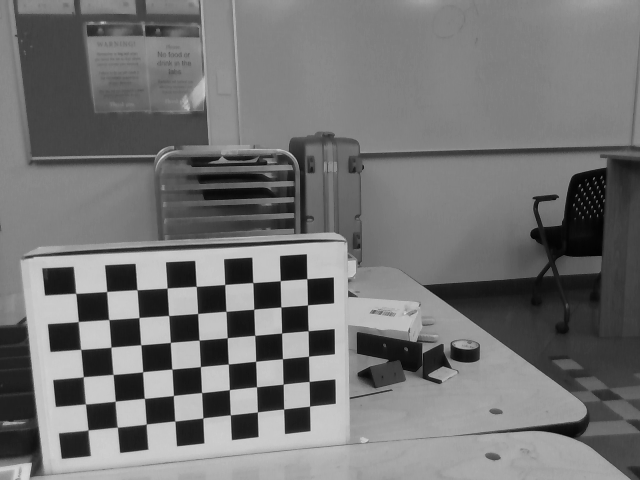
output/image_6.png
