jaz404/visarm/output/image_7.png

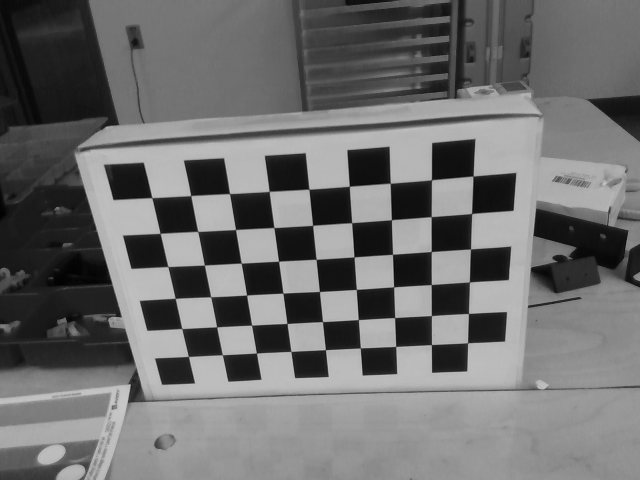
output/image_7.png
