jaz404/visarm/output/image_8.png

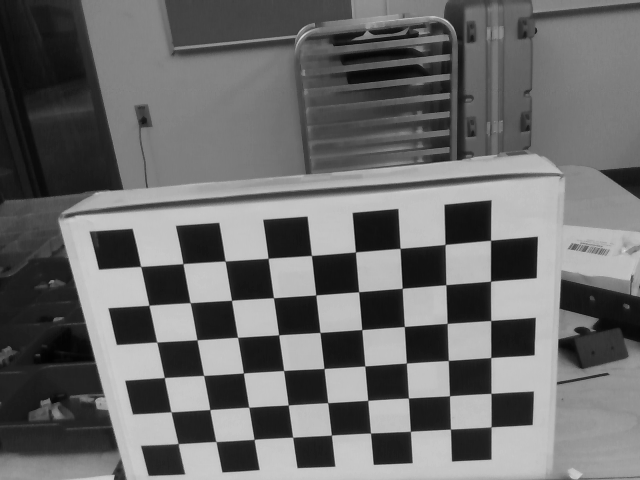
output/image_8.png
