jaz404/visarm/output/image_9.png

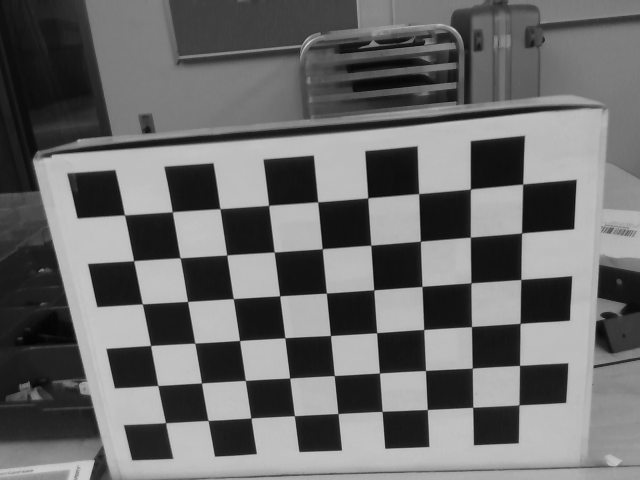
output/image_9.png
