jaz404/visarm/output/image_10.png

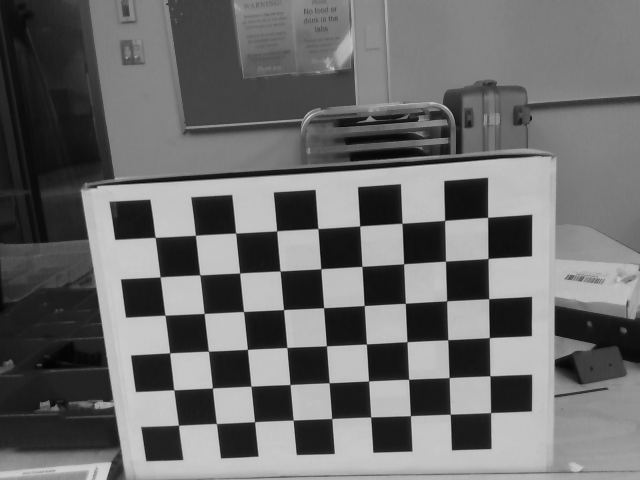
output/image_10.png
