jaz404/visarm/output/image_11.png

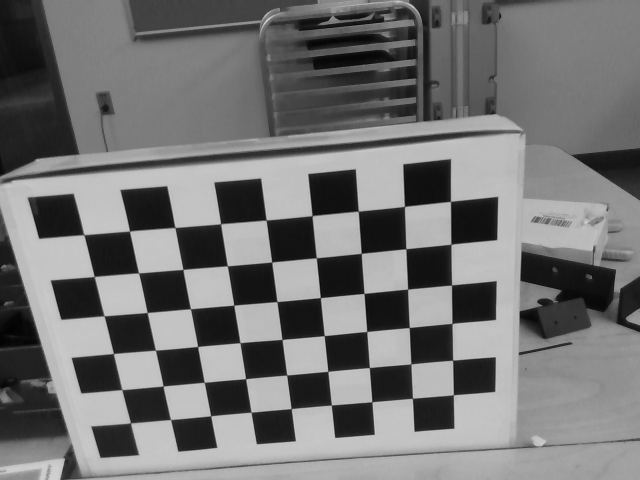
output/image_11.png
