jaz404/visarm/output/image_12.png

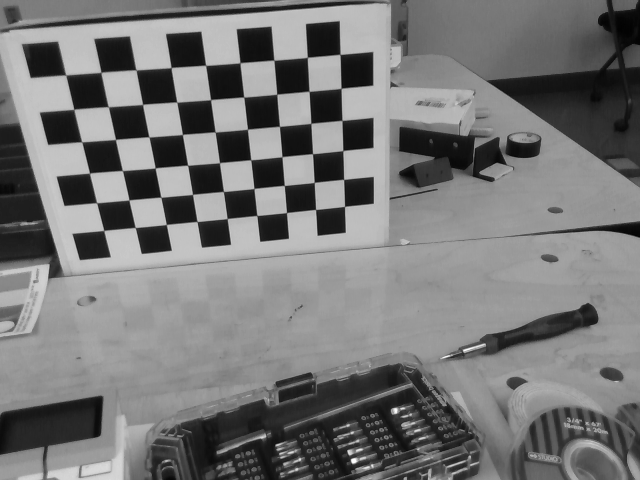
output/image_12.png
