jaz404/visarm/output/image_13.png

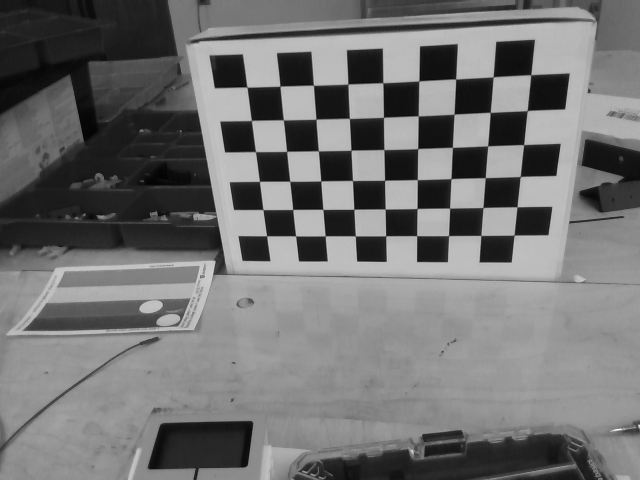
output/image_13.png
