jaz404/visarm/output/image_14.png

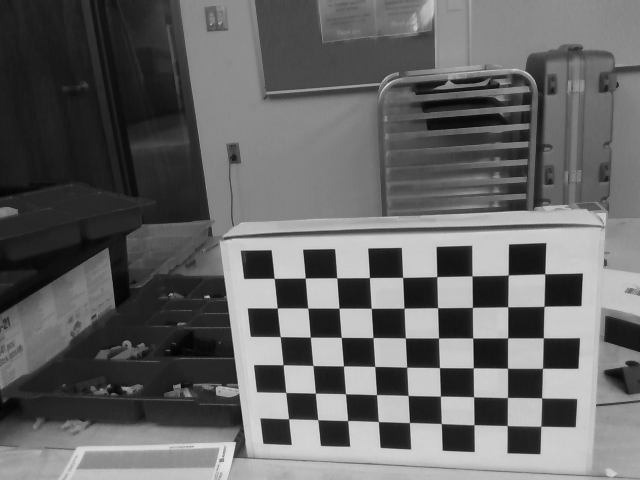
output/image_14.png
