jaz404/visarm/images/model_test/test1.jpeg

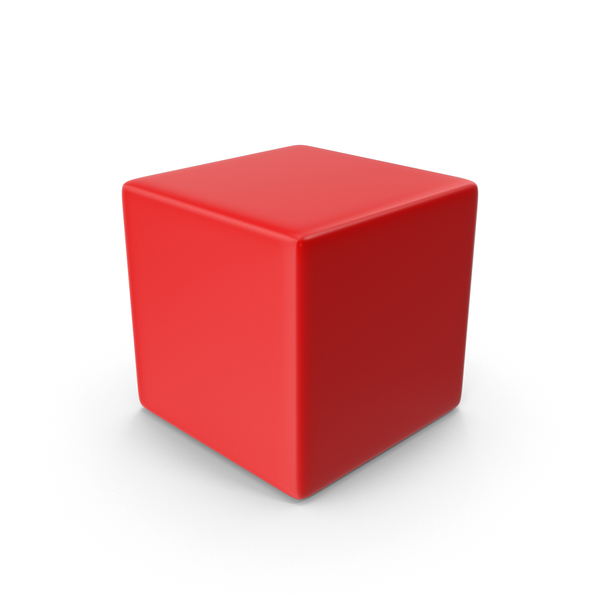
images/model_test/test1.jpeg
