jaz404/visarm/images/model_test/test2.jpg

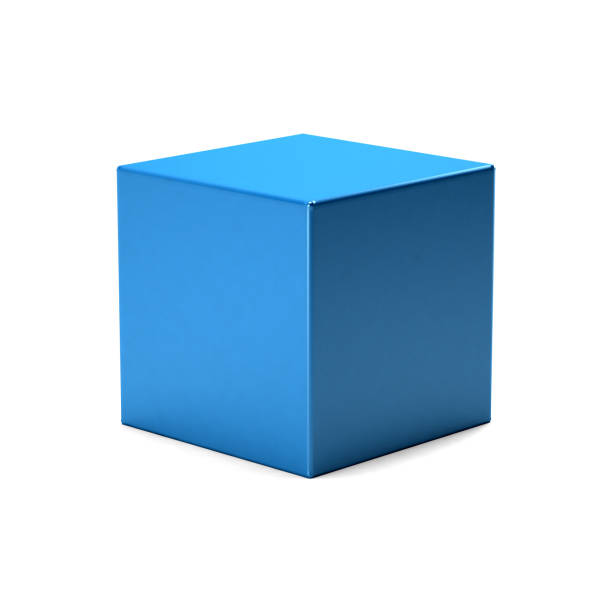
images/model_test/test2.jpg
