jaz404/visarm/matlab_calib/test_img_Color.png

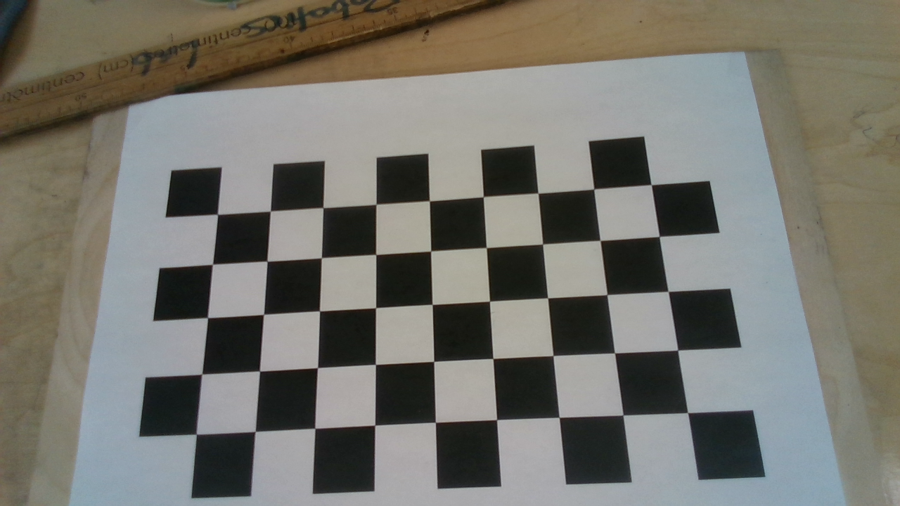
matlab_calib/test_img_Color.png
