jaz404/visarm/(commit log)

2025-11-06 servo examples and sweep
2025-11-08 joint bounds
2025-11-11 Added initial code to get started, still bugs in the actual analytical solution
    [arm_visualizer.py, kinematics.py, main.py, visual.py]
2025-11-13 updated joint angles
2025-11-16 Forward Kinematics fixed. Fixed DH params
    [arm_visualizer.py, kinematics.py, visual.py]
2025-11-20 Converted code to cpp, add calibration code
2025-11-22 Corrected the calibration code
    [arm_visualizer.py, visual.py]
2025-11-25 camera and vision
2025-12-01 Fixed the main loop
    [main.py, visarm.py]
